raumzeitlabor/lichtsteuerung/README.md

RaumZeitLabor Lichtsteuerung
============================

https://wiki.raumzeitlabor.de/wiki/Lichtsteuerung
