raumzeitlabor/lichtsteuerung/Lichtsteuerung_bot.png

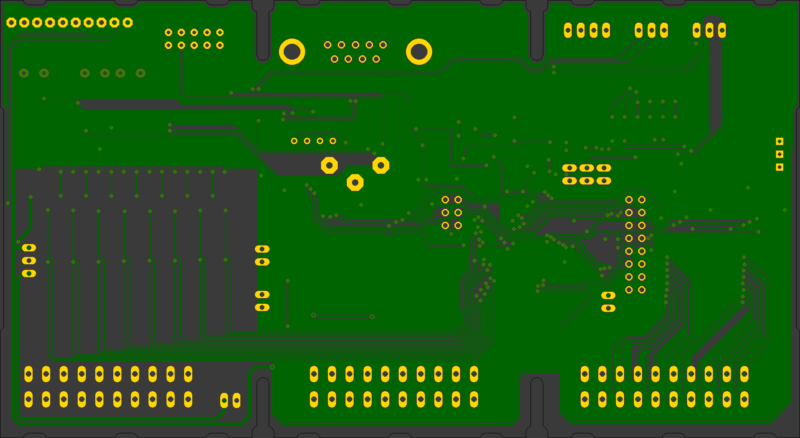
Lichtsteuerung_bot.png
