raumzeitlabor/lichtsteuerung/Lichtsteuerung_sheet1.png

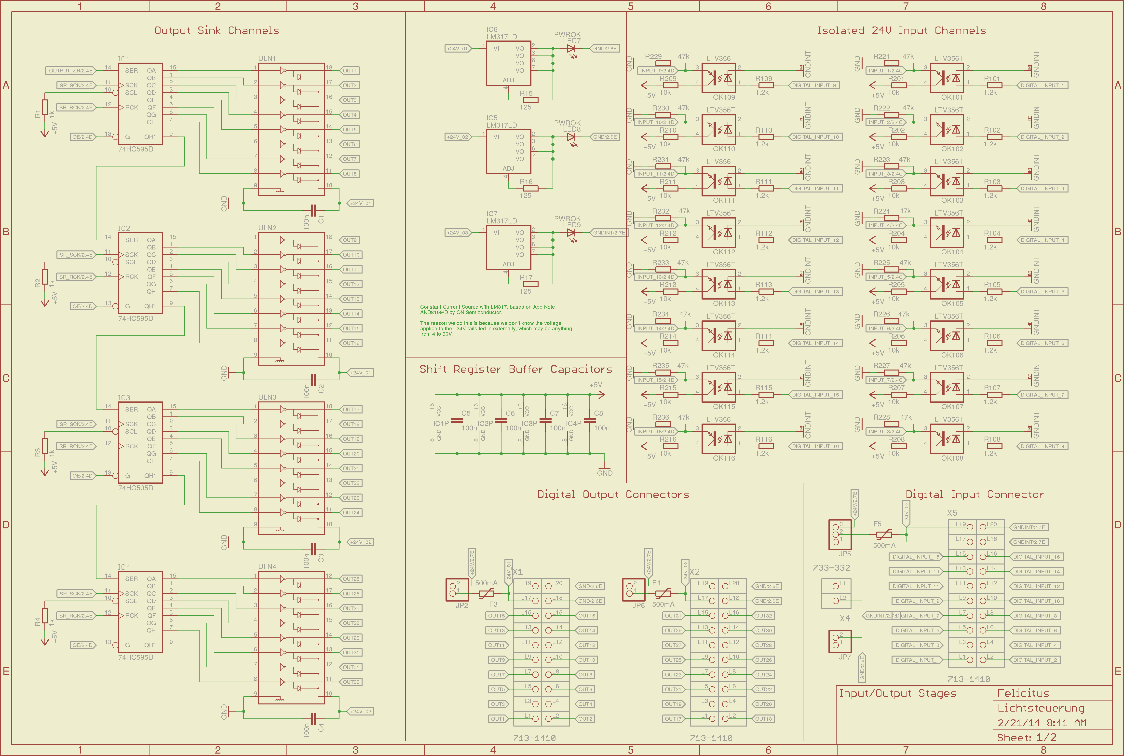
Lichtsteuerung_sheet1.png
