raumzeitlabor/lichtsteuerung/Lichtsteuerung_sheet2.png

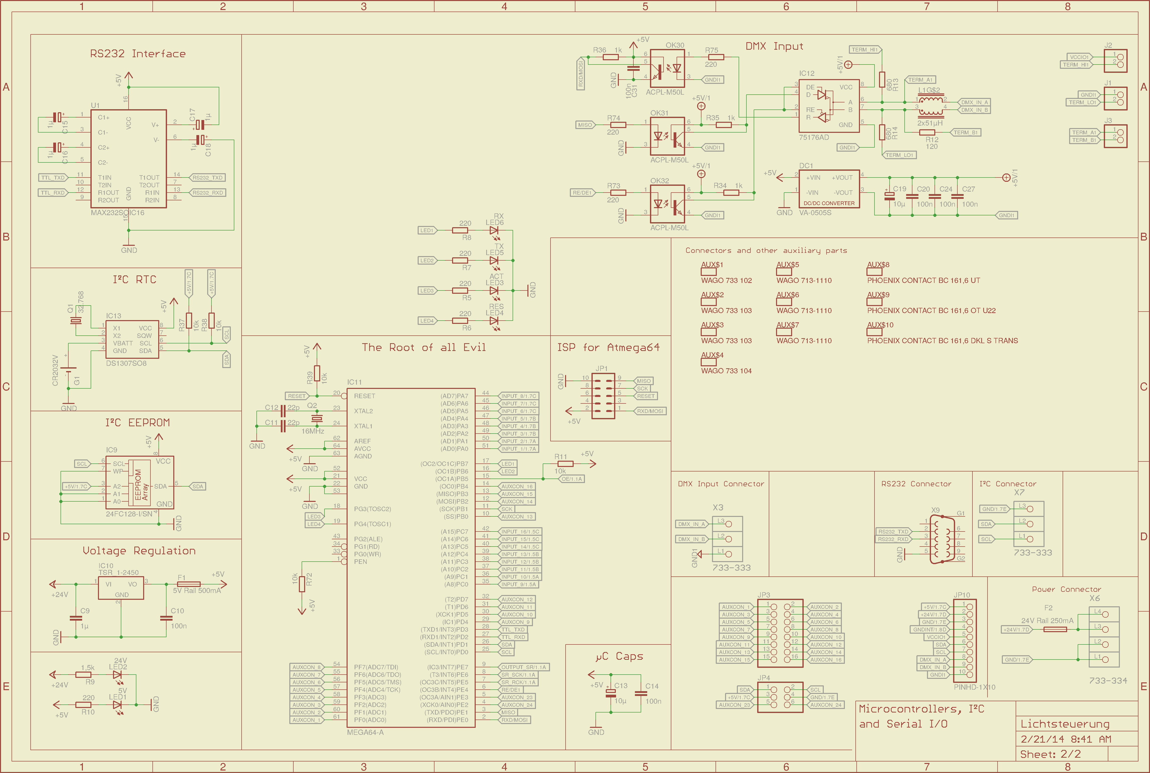
Lichtsteuerung_sheet2.png
