raumzeitlabor/lichtsteuerung/Lichtsteuerung_top.png

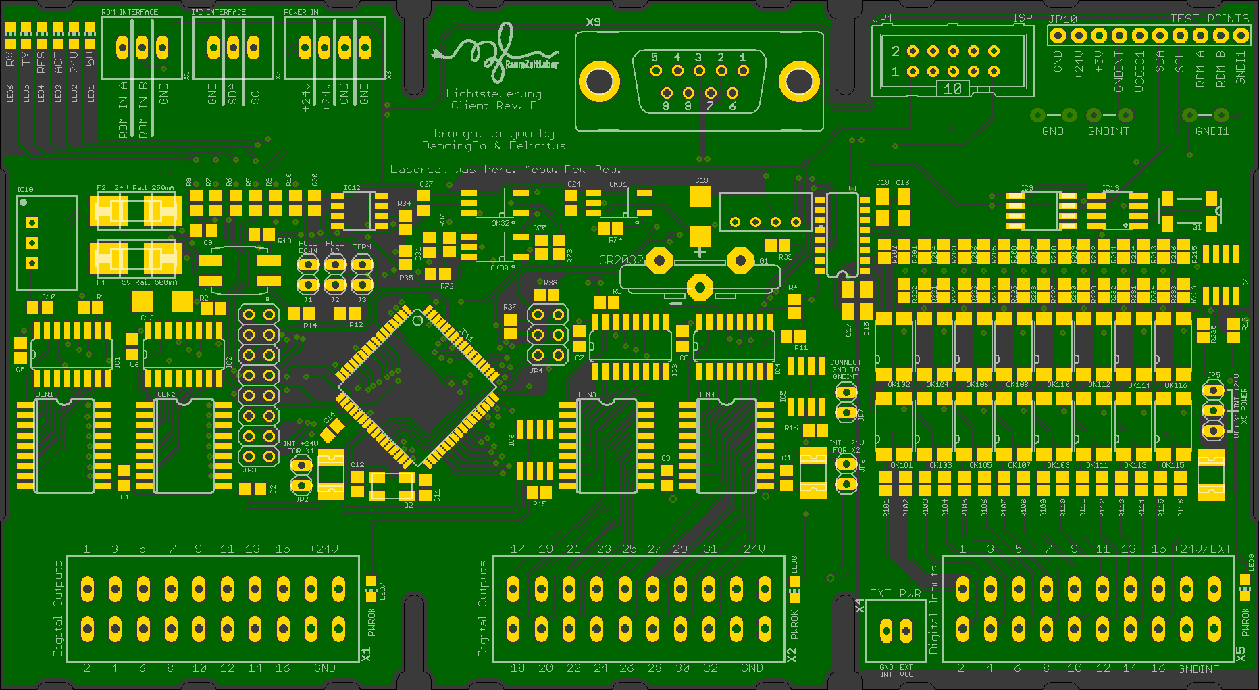
Lichtsteuerung_top.png
