raumzeitlabor/lichtsteuerung/Lichtsteuerung.brd

## EAGLE design Lichtsteuerung.brd (2016-08-28)

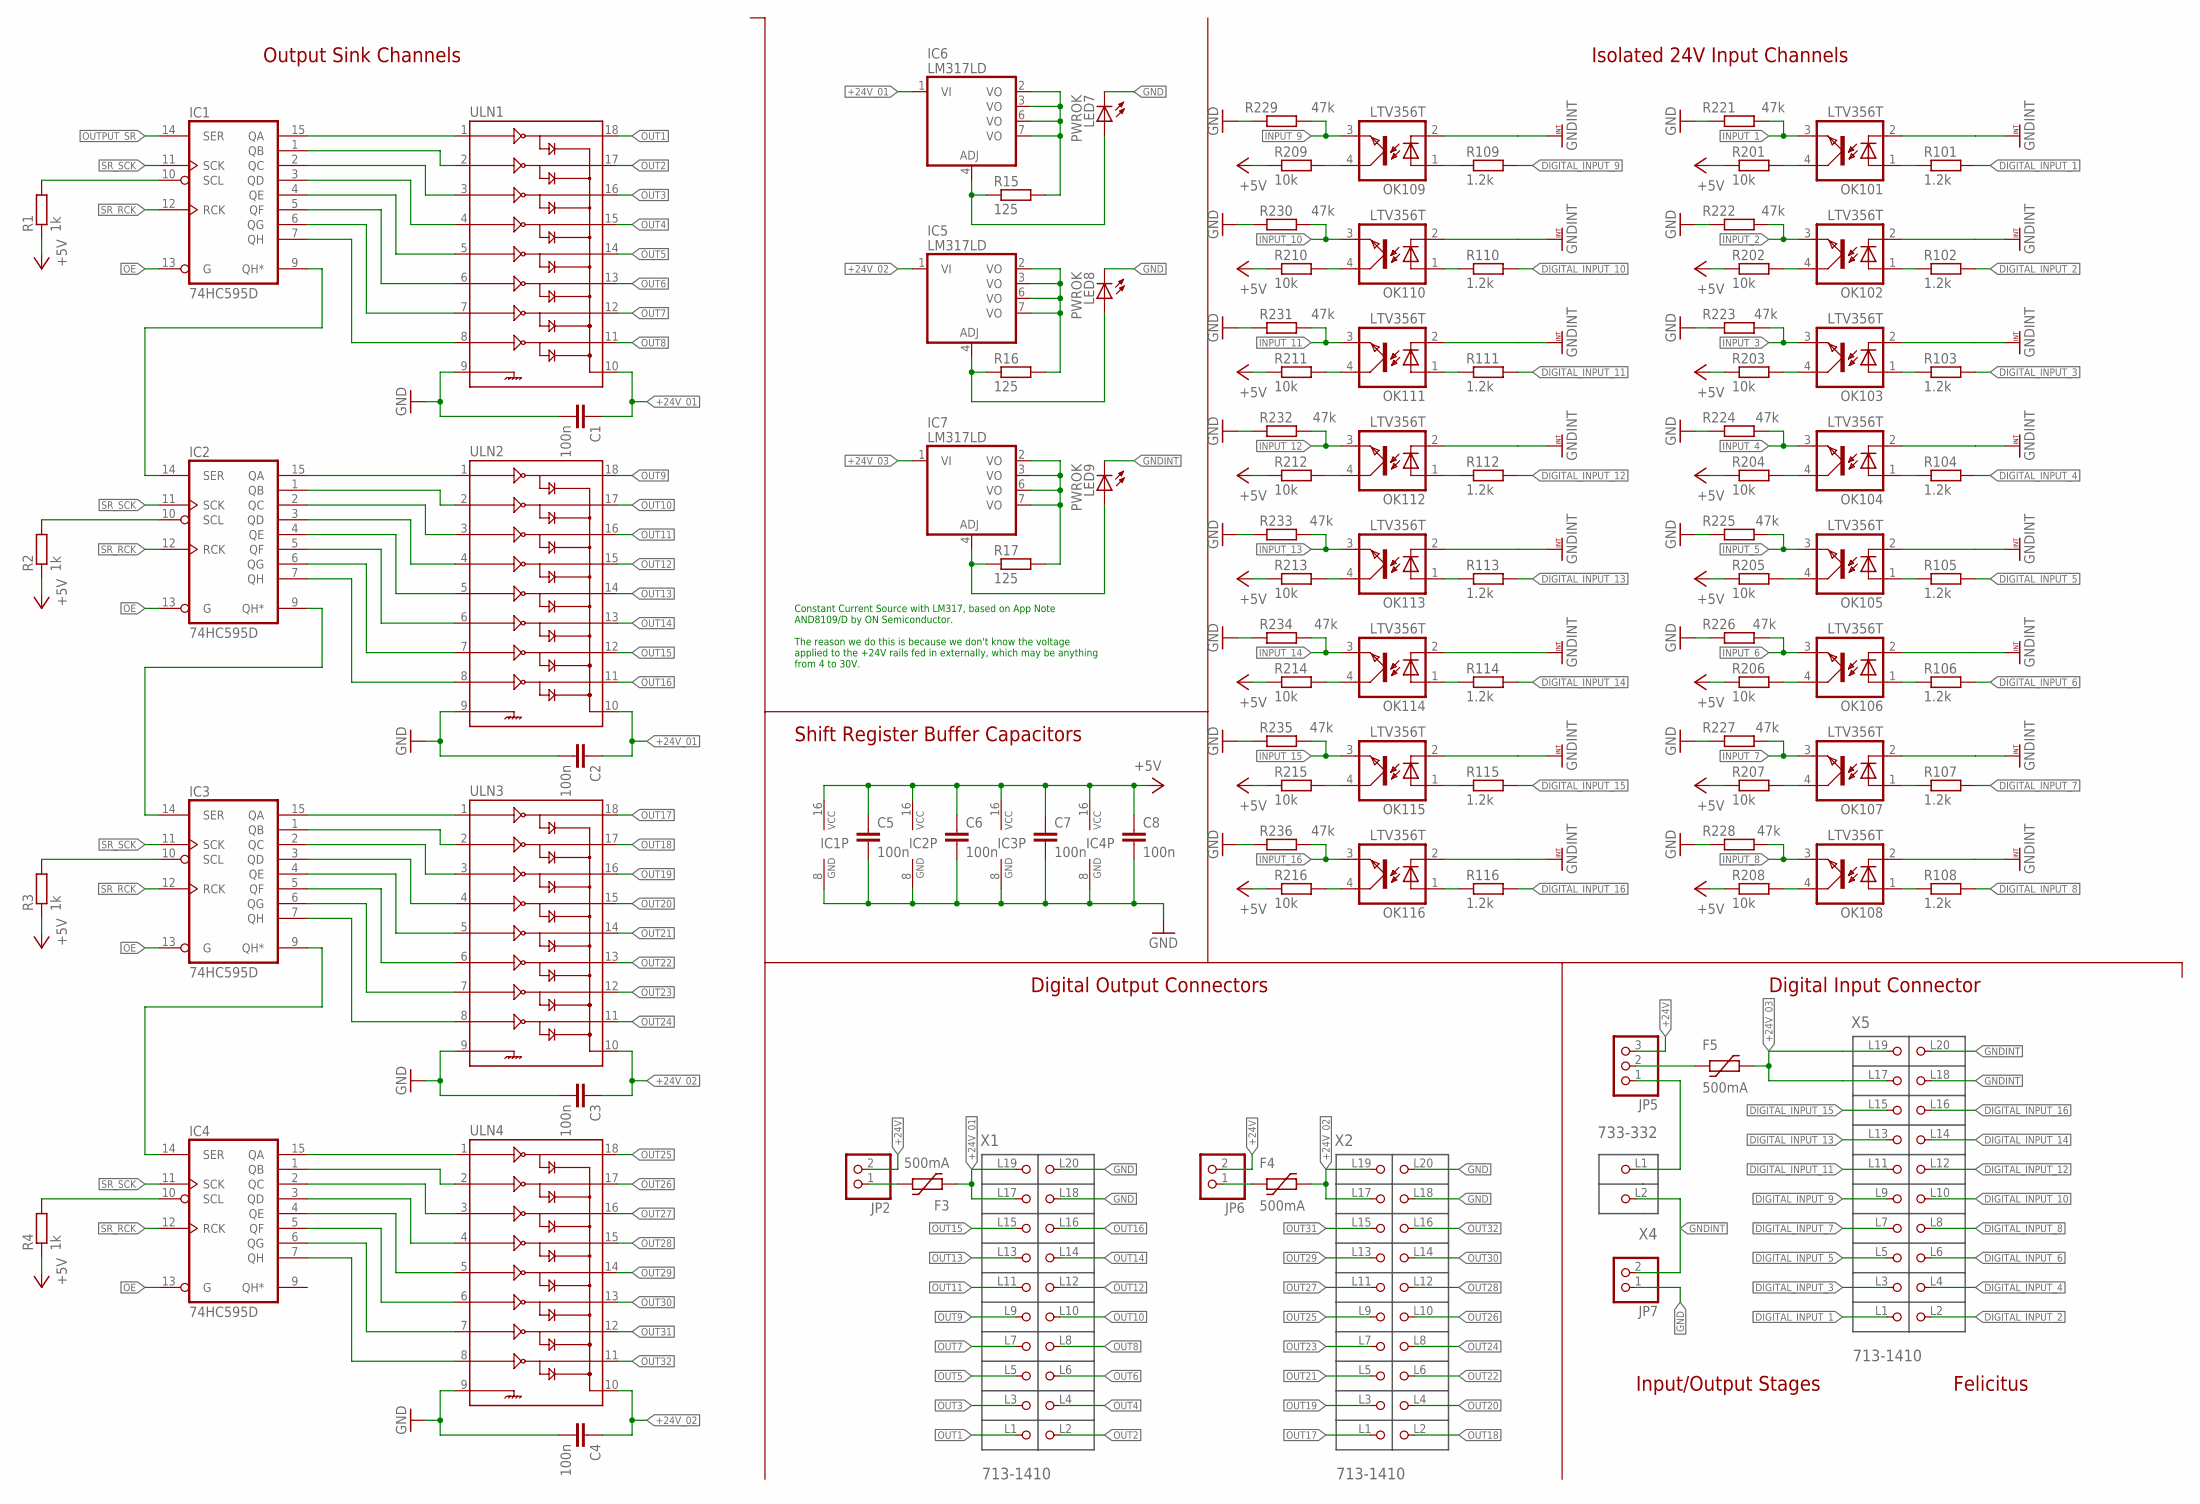
[picture p5: schematic Lichtsteuerung.sch, sheet 1]

Parts:
C1, C2, C3, C4, C5, C6, C7, C8: 100n; C0805
F3, F4, F5: 500mA; 1812L
IC1, IC2, IC3, IC4: 74HC595D; SO16
IC5, IC6, IC7: LM317LD; SO08
JP2, JP6, JP7: PINHD-1X2; 1X02
JP5: PINHD-1X3; 1X03
LED7, LED8, LED9: PWROK; CHIP-LED0805
OK101, OK102, OK103, OK104, OK105, OK106, OK107, OK108, OK109, OK110, OK111, OK112, OK113, OK114, OK115, OK116: LTV356T; SMD4
R1, R2, R3, R4: 1k; R0805
R15, R16, R17: 125; R0805
R101, R102, R103, R104, R105, R106, R107, R108, R109, R110, R111, R112, R113, R114, R115, R116: 1.2k; R0805
R201, R202, R203, R204, R205, R206, R207, R208, R209, R210, R211, R212, R213, R214, R215, R216: 10k; R0805
R221, R222, R223, R224, R225, R226, R227, R228, R229, R230, R231, R232, R233, R234, R235, R236: 47k; R0805
ULN1, ULN2, ULN3, ULN4: ULN2803SOICW; SO18L
X1, X2, X5: 713-1410; P-713-1410
X4: 733-332; P-733-332

Connections:
+5V: C5.1, C6.1, C7.1, C8.1, IC1.16 (VCC), IC2.16 (VCC), IC3.16 (VCC), IC4.16 (VCC), R1.1, R2.1, R3.1, R4.1, R201.1, R202.1, R203.1, R204.1, R205.1, R206.1, R207.1, R208.1, R209.1, R210.1, R211.1, R212.1, R213.1, R214.1, R215.1, R216.1; also elsewhere on the board
+24V: JP2.2, JP5.3, JP6.2; also elsewhere on the board
+24V_01: C1.1, C2.1, F3.P$1 (1), IC6.1 (VI), ULN1.10, ULN2.10, X1.L17, X1.L19
+24V_02: C3.1, C4.1, F4.P$2 (2), IC5.1 (VI), ULN3.10, ULN4.10, X2.L17, X2.L19
+24V_03: F5.P$2 (2), IC7.1 (VI), X5.L17, X5.L19
DIGITAL_INPUT_1: R101.2, X5.L1
DIGITAL_INPUT_2: R102.2, X5.L2
DIGITAL_INPUT_3: R103.2, X5.L3
DIGITAL_INPUT_4: R104.2, X5.L4
DIGITAL_INPUT_5: R105.2, X5.L5
DIGITAL_INPUT_6: R106.2, X5.L6
DIGITAL_INPUT_7: R107.2, X5.L7
DIGITAL_INPUT_8: R108.2, X5.L8
DIGITAL_INPUT_9: R109.2, X5.L9
DIGITAL_INPUT_10: R110.2, X5.L10
DIGITAL_INPUT_11: R111.2, X5.L11
DIGITAL_INPUT_12: R112.2, X5.L12
DIGITAL_INPUT_13: R113.2, X5.L13
DIGITAL_INPUT_14: R114.2, X5.L14
DIGITAL_INPUT_15: R115.2, X5.L15
DIGITAL_INPUT_16: R116.2, X5.L16
GND: C1.2, C2.2, C3.2, C4.2, C5.2, C6.2, C7.2, C8.2, IC1.8 (GND), IC2.8 (GND), IC3.8 (GND), IC4.8 (GND), JP7.1, LED7.C, LED8.C, R221.1, R222.1, R223.1, R224.1, R225.1, R226.1, R227.1, R228.1, R229.1, R230.1, R231.1, R232.1, R233.1, R234.1, R235.1, R236.1, ULN1.9, ULN2.9, ULN3.9, ULN4.9, X1.L18, X1.L20, X2.L18, X2.L20; also elsewhere on the board
GNDINT: JP7.2, LED9.C, OK101.2 (C), OK102.2 (C), OK103.2 (C), OK104.2 (C), OK105.2 (C), OK106.2 (C), OK107.2 (C), OK108.2 (C), OK109.2 (C), OK110.2 (C), OK111.2 (C), OK112.2 (C), OK113.2 (C), OK114.2 (C), OK115.2 (C), OK116.2 (C), X4.L2 (P2), X5.L18, X5.L20; also elsewhere on the board
INPUT_1: OK101.3 (EMIT), R221.2; also elsewhere on the board
INPUT_2: OK102.3 (EMIT), R222.2; also elsewhere on the board
INPUT_3: OK103.3 (EMIT), R223.2; also elsewhere on the board
INPUT_4: OK104.3 (EMIT), R224.2; also elsewhere on the board
INPUT_5: OK105.3 (EMIT), R225.2; also elsewhere on the board
INPUT_6: OK106.3 (EMIT), R226.2; also elsewhere on the board
INPUT_7: OK107.3 (EMIT), R227.2; also elsewhere on the board
INPUT_8: OK108.3 (EMIT), R228.2; also elsewhere on the board
INPUT_9: OK109.3 (EMIT), R229.2; also elsewhere on the board
INPUT_10: OK110.3 (EMIT), R230.2; also elsewhere on the board
INPUT_11: OK111.3 (EMIT), R231.2; also elsewhere on the board
INPUT_12: OK112.3 (EMIT), R232.2; also elsewhere on the board
INPUT_13: OK113.3 (EMIT), R233.2; also elsewhere on the board
INPUT_14: OK114.3 (EMIT), R234.2; also elsewhere on the board
INPUT_15: OK115.3 (EMIT), R235.2; also elsewhere on the board
INPUT_16: OK116.3 (EMIT), R236.2; also elsewhere on the board
unnamed: IC1.15 (QA), ULN1.1
unnamed: IC1.1 (QB), ULN1.2
unnamed: IC1.2 (QC), ULN1.3
unnamed: IC1.3 (QD), ULN1.4
unnamed: IC1.4 (QE), ULN1.5
unnamed: IC1.5 (QF), ULN1.6
unnamed: IC1.6 (QG), ULN1.7
unnamed: IC1.7 (QH), ULN1.8
unnamed: IC2.15 (QA), ULN2.1
unnamed: IC2.1 (QB), ULN2.2
unnamed: IC2.2 (QC), ULN2.3
unnamed: IC2.3 (QD), ULN2.4
unnamed: IC2.4 (QE), ULN2.5
unnamed: IC2.5 (QF), ULN2.6
unnamed: IC2.6 (QG), ULN2.7
unnamed: IC2.7 (QH), ULN2.8
unnamed: IC3.15 (QA), ULN3.1
unnamed: IC3.1 (QB), ULN3.2
unnamed: IC3.2 (QC), ULN3.3
unnamed: IC3.3 (QD), ULN3.4
unnamed: IC3.4 (QE), ULN3.5
unnamed: IC3.5 (QF), ULN3.6
unnamed: IC3.6 (QG), ULN3.7
unnamed: IC3.7 (QH), ULN3.8
unnamed: IC4.15 (QA), ULN4.1
unnamed: IC4.1 (QB), ULN4.2
unnamed: IC4.2 (QC), ULN4.3
unnamed: IC4.3 (QD), ULN4.4
unnamed: IC4.4 (QE), ULN4.5
unnamed: IC4.5 (QF), ULN4.6
unnamed: IC4.6 (QG), ULN4.7
unnamed: IC4.7 (QH), ULN4.8
unnamed: IC1.9 (QH*), IC2.14 (SER)
unnamed: IC2.9 (QH*), IC3.14 (SER)
unnamed: IC3.9 (QH*), IC4.14 (SER)
unnamed: IC1.10 (SCL), R1.2
unnamed: IC2.10 (SCL), R2.2
unnamed: IC3.10 (SCL), R3.2
unnamed: IC4.10 (SCL), R4.2
unnamed: F5.P$1 (1), JP5.2
unnamed: JP5.1, X4.L1 (P1)
unnamed: OK101.1 (A), R101.1
unnamed: OK101.4 (COL), R201.2
unnamed: OK102.1 (A), R102.1
unnamed: OK102.4 (COL), R202.2
unnamed: OK103.1 (A), R103.1
unnamed: OK103.4 (COL), R203.2
unnamed: OK104.1 (A), R104.1
unnamed: OK104.4 (COL), R204.2
unnamed: OK105.1 (A), R105.1
unnamed: OK105.4 (COL), R205.2
unnamed: OK106.1 (A), R106.1
unnamed: OK106.4 (COL), R206.2
unnamed: OK107.1 (A), R107.1
unnamed: OK107.4 (COL), R207.2
unnamed: OK108.1 (A), R108.1
unnamed: OK108.4 (COL), R208.2
unnamed: OK109.1 (A), R109.1
unnamed: OK109.4 (COL), R209.2
unnamed: OK110.1 (A), R110.1
unnamed: OK110.4 (COL), R210.2
unnamed: OK111.1 (A), R111.1
unnamed: F4.P$1 (1), JP6.1
unnamed: OK111.4 (COL), R211.2
unnamed: F3.P$2 (2), JP2.1
unnamed: OK112.1 (A), R112.1
unnamed: IC5.4 (ADJ), LED8.A, R16.1
unnamed: OK112.4 (COL), R212.2
unnamed: IC5.2 (VO), IC5.3 (VO), IC5.6 (VO), IC5.7 (VO), R16.2
unnamed: IC7.4 (ADJ), LED9.A, R17.1
unnamed: OK113.1 (A), R113.1
unnamed: IC6.4 (ADJ), LED7.A, R15.1
unnamed: IC6.2 (VO), IC6.3 (VO), IC6.6 (VO), IC6.7 (VO), R15.2
unnamed: OK113.4 (COL), R213.2
unnamed: IC7.2 (VO), IC7.3 (VO), IC7.6 (VO), IC7.7 (VO), R17.2
unnamed: OK114.1 (A), R114.1
unnamed: OK114.4 (COL), R214.2
unnamed: OK115.1 (A), R115.1
unnamed: OK115.4 (COL), R215.2
unnamed: OK116.1 (A), R116.1
unnamed: OK116.4 (COL), R216.2
OE: IC1.13 (G), IC2.13 (G), IC3.13 (G), IC4.13 (G); also elsewhere on the board
OUT1: ULN1.18, X1.L1
OUT2: ULN1.17, X1.L2
OUT3: ULN1.16, X1.L3
OUT4: ULN1.15, X1.L4
OUT5: ULN1.14, X1.L5
OUT6: ULN1.13, X1.L6
OUT7: ULN1.12, X1.L7
OUT8: ULN1.11, X1.L8
OUT9: ULN2.18, X1.L9
OUT10: ULN2.17, X1.L10
OUT11: ULN2.16, X1.L11
OUT12: ULN2.15, X1.L12
OUT13: ULN2.14, X1.L13
OUT14: ULN2.13, X1.L14
OUT15: ULN2.12, X1.L15
OUT16: ULN2.11, X1.L16
OUT17: ULN3.18, X2.L1
OUT18: ULN3.17, X2.L2
OUT19: ULN3.16, X2.L3
OUT20: ULN3.15, X2.L4
OUT21: ULN3.14, X2.L5
OUT22: ULN3.13, X2.L6
OUT23: ULN3.12, X2.L7
OUT24: ULN3.11, X2.L8
OUT25: ULN4.18, X2.L9
OUT26: ULN4.17, X2.L10
OUT27: ULN4.16, X2.L11
OUT28: ULN4.15, X2.L12
OUT29: ULN4.14, X2.L13
OUT30: ULN4.13, X2.L14
OUT31: ULN4.12, X2.L15
OUT32: ULN4.11, X2.L16
OUTPUT_SR: IC1.14 (SER); also elsewhere on the board
SR_RCK: IC1.12 (RCK), IC2.12 (RCK), IC3.12 (RCK), IC4.12 (RCK); also elsewhere on the board
SR_SCK: IC1.11 (SCK), IC2.11 (SCK), IC3.11 (SCK), IC4.11 (SCK); also elsewhere on the board

Notes on the sheet:
Felicitus
Output Sink Channels
Shift Register Buffer Capacitors
Input/Output Stages
Isolated 24V Input Channels
Digital Input Connector
Digital Output Connectors
Constant Current Source with LM317, based on App Note AND8109/D by ON Semiconductor. The reason we do this is because we don't know the voltage applied to the +24V rails fed in externally, which may be anything from 4 to 30V.

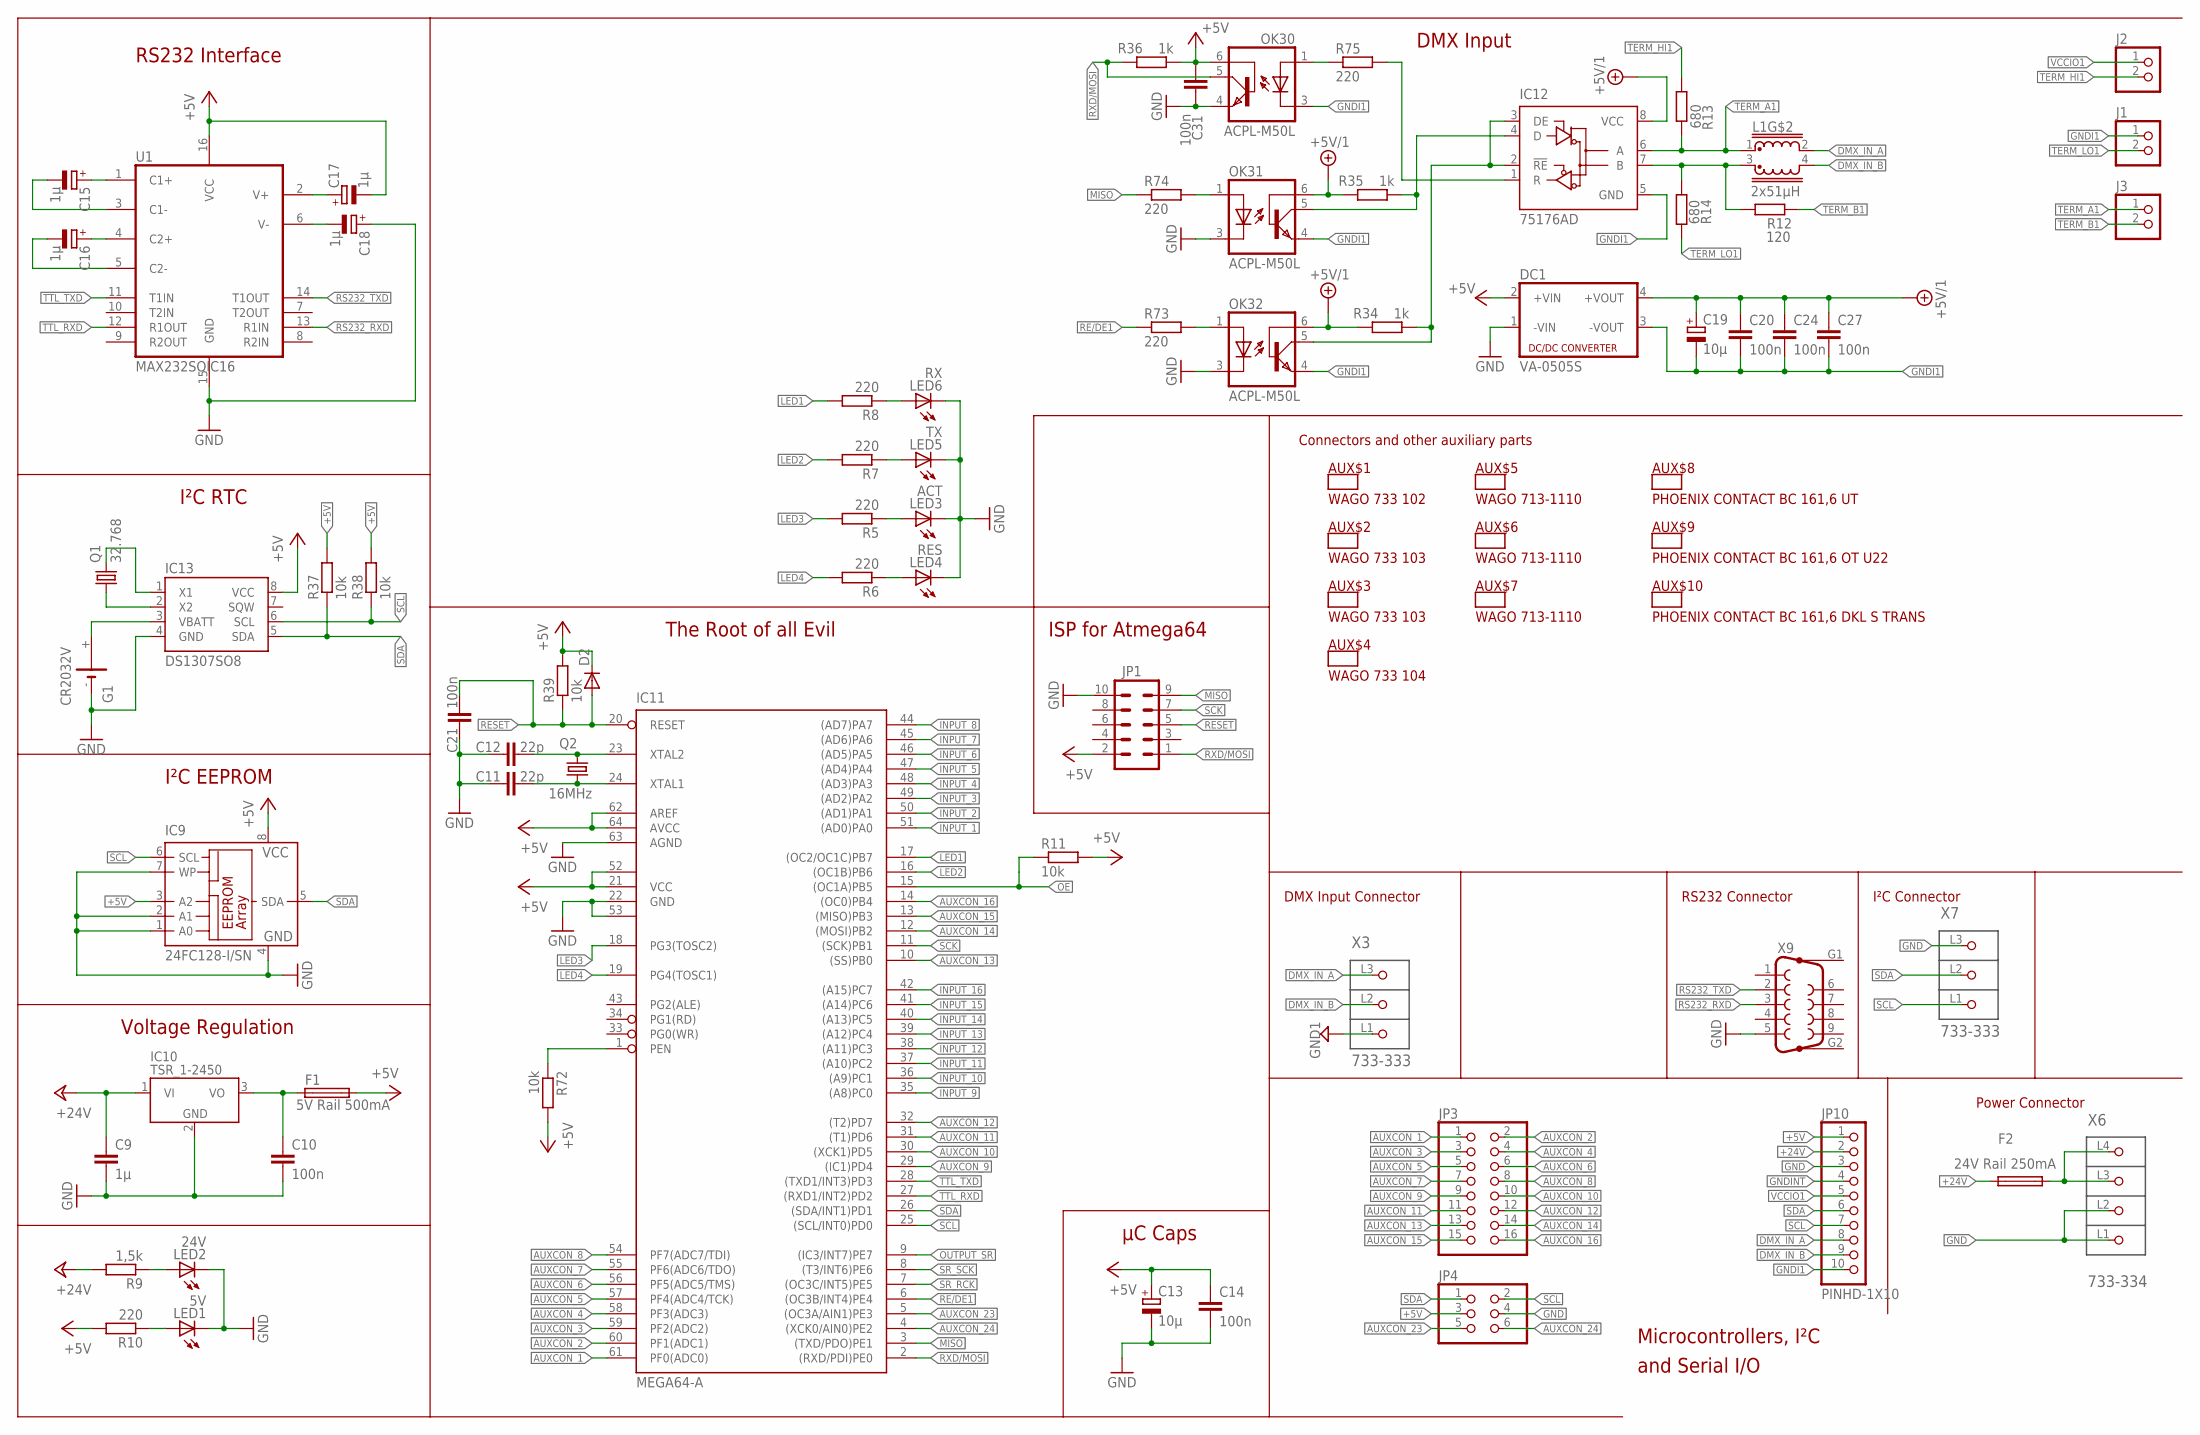
[picture p6: schematic Lichtsteuerung.sch, sheet 2]

Parts:
C9: 1µ; C0805
C10, C14, C20, C21, C24, C27, C31: 100n; C0805
C11, C12: 22p; C0805
C13, C19: 10µ; C/6032-28R; PARTKEEPR_SKU 2607
C15, C16, C17, C18: 1µ; A/3216-18R; PARTKEEPR_SKU 2609
D2: DIODE-SOD323-R; SOD323-R
DC1: VA-0505S; 4SIL
F1: 5V Rail 500mA; OMNIBLOK
F2: 24V Rail 250mA; OMNIBLOK
G1: CR2032V; CR2032V2
IC9: 24FC128-I/SN; SO-08M
IC10: TSR_1-2450; TSR-1
IC11: MEGA64-A; TQFP64
IC12: 75176AD; D_R-PDSO-G8
IC13: DS1307SO8; SO08
J1, J2, J3: PINHD-1X2; 1X02
JP1: ML10
JP3: PINHD-2X8; 2X08
JP4: PINHD-2X3; 2X03
JP10: PINHD-1X10; 1X10-BIG
L1: 2x51µH; EPCOS_B82790_SERIES
LED1: 5V; CHIP-LED0805
LED2: 24V; CHIP-LED0805
LED3: ACT; CHIP-LED0805
LED4: RES; CHIP-LED0805
LED5: TX; CHIP-LED0805
LED6: RX; CHIP-LED0805
OK30, OK31, OK32: ACPL-M50L; JEDEC_MS-012-AA_SOIC5
Q1: 32.768; MC-306
Q2: 16MHz; MJ
R5, R6, R7, R8, R10, R73, R74, R75: 220; R0805
R9: 1,5k; R0805
R11, R37, R38, R39, R72: 10k; R0805
R12: 120; R0805
R13, R14: 680; R0805
R34, R35, R36: 1k; R0805
U1: MAX232SOIC16; SO016
X3, X7: 733-333; P-733-333
X6: 733-334; P-733-334
X9: F09VP

Connections:
+5V: C13.+, C14.1, C17.-, C31.1, D2.C, DC1.2 (+VIN), F1.P$2 (2), IC9.3 (A2), IC9.8 (VCC), IC11.21 (VCC), IC11.52 (VCC1), IC11.62 (AREF), IC11.64 (AVCC), IC13.8 (VCC), JP1.2, JP4.3, JP10.1, OK30.6 (BAS), R10.2, R11.2, R36.1, R37.2, R38.2, R39.2, R72.2, U1.16 (VCC); also elsewhere on the board
+24V: C9.1, F2.P$1 (1), IC10.1 (VI), JP10.2, R9.2; also elsewhere on the board
+24VIN: F2.P$2 (2), X6.L3 (P3), X6.L4 (P4)
AUXCON_1: IC11.61 (PF0(ADC0)), JP3.1
AUXCON_2: IC11.60 (PF1(ADC1)), JP3.2
AUXCON_3: IC11.59 (PF2(ADC2)), JP3.3
AUXCON_4: IC11.58 (PF3(ADC3)), JP3.4
AUXCON_5: IC11.57 (PF4(ADC4/TCK)), JP3.5
AUXCON_6: IC11.56 (PF5(ADC5/TMS)), JP3.6
AUXCON_7: IC11.55 (PF6(ADC6/TDO)), JP3.7
AUXCON_8: IC11.54 (PF7(ADC7/TDI)), JP3.8
AUXCON_9: IC11.29 ((IC1)PD4), JP3.9
AUXCON_10: IC11.30 ((XCK1)PD5), JP3.10
AUXCON_11: IC11.31 ((T1)PD6), JP3.11
AUXCON_12: IC11.32 ((T2)PD7), JP3.12
AUXCON_13: IC11.10 ((SS)PB0), JP3.13
AUXCON_14: IC11.12 ((MOSI)PB2), JP3.14
AUXCON_15: IC11.13 ((MISO)PB3), JP3.15
AUXCON_16: IC11.14 ((OC0)PB4), JP3.16
AUXCON_23: IC11.5 ((OC3A/AIN1)PE3), JP4.5
AUXCON_24: IC11.4 ((XCK0/AIN0)PE2), JP4.6
DMX_IN_A: JP10.8, L1.2 (4), X3.L3 (P3)
DMX_IN_B: JP10.9, L1.4, X3.L2 (P2)
GND: C9.2, C10.2, C11.2, C12.2, C13.-, C14.2, C18.+, C21.2, C31.2, DC1.1 (-VIN), G1.-, IC9.1 (A0), IC9.2 (A1), IC9.4 (GND), IC9.7 (WP), IC10.2 (GND), IC11.22 (GND), IC11.53 (GND1), IC11.63 (AGND), IC13.4 (GND), JP1.10, JP4.4, JP10.3, LED1.C, LED2.C, LED3.C, LED4.C, LED5.C, LED6.C, OK30.4 (EMI), OK31.3 (C), OK32.3 (C), U1.15 (GND), X6.L1 (P1), X6.L2 (P2), X7.L3 (P3), X9.5; also elsewhere on the board
GNDI1: C19.-, C20.2, C24.2, C27.2, DC1.3 (-VOUT), IC12.5 (GND), J1.1, JP10.10, OK30.3 (C), OK31.4 (EMI), OK32.4 (EMI), X3.L1 (P1)
GNDINT: JP10.4; also elsewhere on the board
INPUT_1: IC11.51 ((AD0)PA0); also elsewhere on the board
INPUT_2: IC11.50 ((AD1)PA1); also elsewhere on the board
INPUT_3: IC11.49 ((AD2)PA2); also elsewhere on the board
INPUT_4: IC11.48 ((AD3)PA3); also elsewhere on the board
INPUT_5: IC11.47 ((AD4)PA4); also elsewhere on the board
INPUT_6: IC11.46 ((AD5)PA5); also elsewhere on the board
INPUT_7: IC11.45 ((AD6)PA6); also elsewhere on the board
INPUT_8: IC11.44 ((AD7)PA7); also elsewhere on the board
INPUT_9: IC11.35 ((A8)PC0); also elsewhere on the board
INPUT_10: IC11.36 ((A9)PC1); also elsewhere on the board
INPUT_11: IC11.37 ((A10)PC2); also elsewhere on the board
INPUT_12: IC11.38 ((A11)PC3); also elsewhere on the board
INPUT_13: IC11.39 ((A12)PC4); also elsewhere on the board
INPUT_14: IC11.40 ((A13)PC5); also elsewhere on the board
INPUT_15: IC11.41 ((A14)PC6); also elsewhere on the board
INPUT_16: IC11.42 ((A15)PC7); also elsewhere on the board
LED1: IC11.17 ((OC2/OC1C)PB7), R8.2
LED2: IC11.16 ((OC1B)PB6), R7.2
LED3: IC11.18 (PG3(TOSC2)), R5.2
LED4: IC11.19 (PG4(TOSC1)), R6.2
MISO: IC11.3 ((TXD/PDO)PE1), JP1.9, R74.1
unnamed: G1.+, IC13.3 (VBATT)
unnamed: C11.1, IC11.24 (XTAL1), Q2.P3 (2)
unnamed: IC13.2 (X2), Q1.1
unnamed: IC13.1 (X1), Q1.4 (2)
unnamed: C12.1, IC11.23 (XTAL2), Q2.P1 (1)
unnamed: LED6.A, R8.1
unnamed: LED5.A, R7.1
unnamed: LED3.A, R5.1
unnamed: C15.+, U1.1 (C1+)
unnamed: C15.-, U1.3 (C1-)
unnamed: LED4.A, R6.1
unnamed: LED1.A, R10.1
unnamed: LED2.A, R9.1
unnamed: IC11.1 (PEN), R72.1
unnamed: C16.+, U1.4 (C2+)
unnamed: C16.-, U1.5 (C2-)
unnamed: C10.1, F1.P$1 (1), IC10.3 (VO)
unnamed: IC12.7 (B), L1.3 (1), R12.2, R14.2
unnamed: OK30.1 (A), R75.1
unnamed: OK31.1 (A), R74.2
unnamed: OK32.1 (A), R73.2
unnamed: C18.-, U1.6 (V-)
unnamed: C17.+, U1.2 (V+)
OE: IC11.15 ((OC1A)PB5), R11.1; also elsewhere on the board
OUTPUT_SR: IC11.9 ((IC3/INT7)PE7); also elsewhere on the board
RE/DE1: IC11.6 ((OC3B/INT4)PE4), R73.1
REC$1: IC12.1 (R), R75.2
RESET: C21.1, D2.A, IC11.20 (RESET), JP1.5, R39.1
RE_OUT: IC12.2 (!RE), IC12.3 (DE), OK32.5 (COL), R34.1
RS232_RXD: U1.13 (R1IN), X9.3
RS232_TXD: U1.14 (T1OUT), X9.2
RXD/MOSI: IC11.2 ((RXD/PDI)PE0), JP1.1, OK30.5 (COL), R36.2
SCK: IC11.11 ((SCK)PB1), JP1.7
SCL: IC9.6 (SCL), IC11.25 ((SCL/INT0)PD0), IC13.6 (SCL), JP4.2, JP10.7, R38.1, X7.L1 (P1)
SDA: IC9.5 (SDA), IC11.26 ((SDA/INT1)PD1), IC13.5 (SDA), JP4.1, JP10.6, R37.1, X7.L2 (P2)
SR_RCK: IC11.7 ((OC3C/INT5)PE5); also elsewhere on the board
SR_SCK: IC11.8 ((T3/INT6)PE6); also elsewhere on the board
TERM_A1: IC12.6 (A), J3.1, L1.1, R13.1
TERM_B1: J3.2, R12.1
TERM_HI1: J2.2, R13.2
TERM_LO1: J1.2, R14.1
TTL_RXD: IC11.27 ((RXD1/INT2)PD2), U1.12 (R1OUT)
TTL_TXD: IC11.28 ((TXD1/INT3)PD3), U1.11 (T1IN)
TXD_OUT: IC12.4 (D), OK31.5 (COL), R35.1
VCCIO1: C19.+, C20.1, C24.1, C27.1, DC1.4 (+VOUT), IC12.8 (VCC), J2.1, JP10.5, OK31.6 (BAS), OK32.6 (BAS), R34.2, R35.2

Notes on the sheet:
I²C EEPROM
I²C RTC
Voltage Regulation
DMX Input
ISP for Atmega64
µC Caps
RS232 Interface
The Root of all Evil
Microcontrollers, I²C
and Serial I/O
DMX Input Connector
RS232 Connector
I²C Connector
Power Connector
Connectors and other auxiliary parts

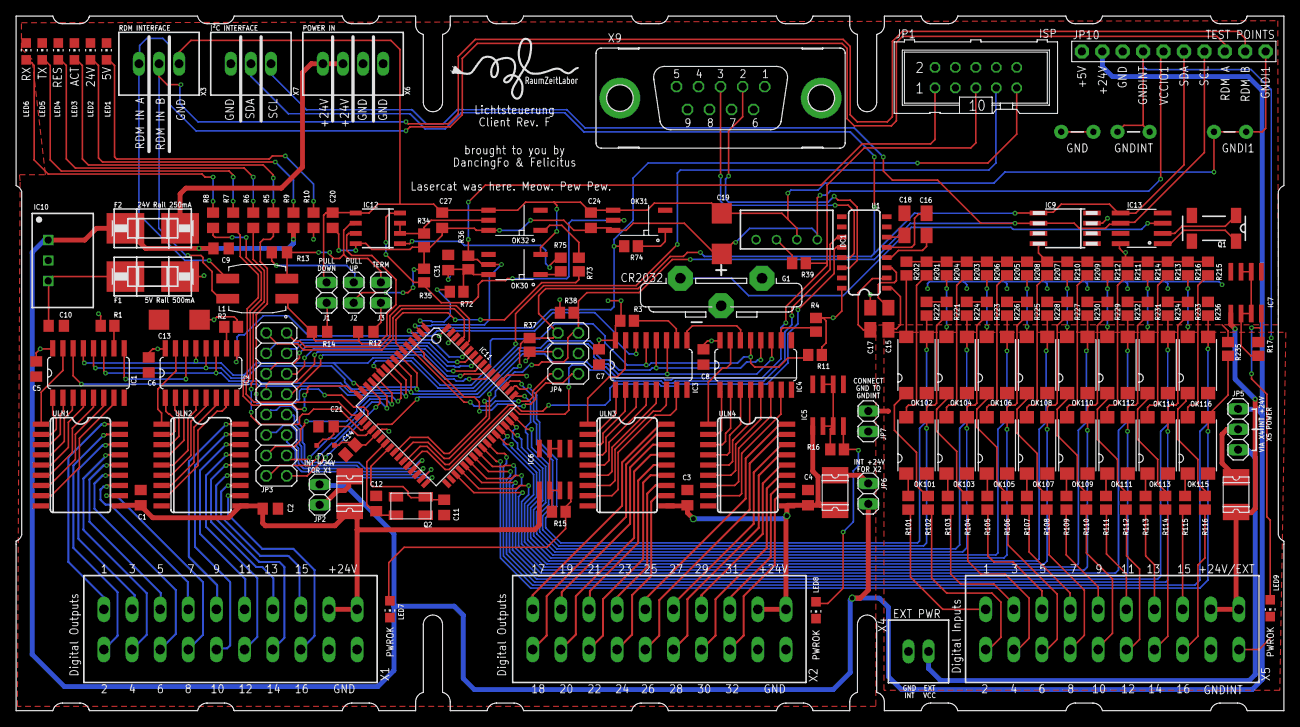
[picture p7: board Lichtsteuerung.brd from above]

Board: 2 copper layers, 157.7 x 86.4 mm, 175 parts (0 on the bottom side), 224 nets.

Other parts of the board:
U$1: RAUMZEITLABOR_FILLED_16MM
