raumzeitlabor/lichtsteuerung/firmware/Lichtsteuerung/bitlashfunctions.ino

#include <avr/pgmspace.h>
#include <bitlash.h>
#include <src/bitlash.h>

#define MODE_TOGGLE 1
#define MODE_MOMENTARY 2
#define MODE_INVALID 99

char buffer[120];

const char usage_setOutputState[] PROGMEM = "Usage: setOutputState(output,state)\n\routput: Output Number (1-32)\n\rstate: State (0 = off, 1 = on)\n\r";
const char usage_setDeviceName[] PROGMEM = "Usage: setDeviceName(deviceName)\n\rdeviceName: ASCII String, 32 chars max\n\r";
const char usage_setOutputName[] PROGMEM = "Usage: setOutputName(port, portName)\n\rport: Output Number (1-32)\n\rportName: ASCII String, 32 chars max\n\r";
const char usage_getOutputName[] PROGMEM = "Usage: getOutputName(port)\n\rport: Output Number (1-32)\n\r";
const char usage_getOutputState[] PROGMEM = "Usage: getOutputState(port)\n\rport: Output Number (1-32)\n\r";
const char usage_toggleOutputState[] PROGMEM = "Usage: toggleOutputState(port)\n\rport: Output Number (1-32)\n\r";
const char usage_setInputName[] PROGMEM = "Usage: setInputName(port, portName)\n\rport: Input Number (1-16)\n\rportName: ASCII String, 32 chars max\n\r";
const char usage_getInputName[] PROGMEM = "Usage: getInputName(port)\n\rport: Input Number (1-16)\n\r";
const char usage_setInputMode[] PROGMEM = "Usage: setInputMode(port,mode)\n\rport: Input Number (1-16)\n\rmode: MODE_TOGGLE or MODE_MOMENTARY\n\rExample: setInputMode(1, \"MODE_MOMENTARY\");\n\r";
const char usage_getInputMode[] PROGMEM = "Usage: getInputMode(port)\n\rport: Input Number (1-16)\n\rPrints either MODE_TOGGLE or MODE_MOMENTARY\n\r";
const char usage_setPrivateFlag[] PROGMEM = "Usage: setPrivateFlag(port, private)\n\rport: Output Number (1-32)\n\rprivate: 0=public, 1=private\n\r";
const char usage_peepE[] PROGMEM = "Usage: peep_e(start_address)\n\rDumps 4096 bytes from the external I2C EEPROM.\n\rstart_address: EEPROM Start Address in decimal or hex (e.g. 0xFFF)\n\r";

PGM_P const usage[] PROGMEM = {
	usage_setOutputState,
	usage_setDeviceName,
	usage_setOutputName,
	usage_getOutputName,
	usage_getOutputState,
	usage_toggleOutputState,
	usage_setInputName,
	usage_getInputName,
	usage_setInputMode,
	usage_getInputMode,
	usage_setPrivateFlag,
	usage_peepE
};

const char messages_setDeviceName[] PROGMEM = "New device name: ";
const char messages_invalidOutputPortNumber[] PROGMEM = "Invalid Output Port Number. Valid values are: 1-32.";
const char messages_invalidInputPortNumber[] PROGMEM = "Invalid Input Port Number. Valid values are: 1-16.";
const char messages_invalidInputMode[] PROGMEM = "Invalid port mode. Valid values are: MODE_TOGGLE or MODE_MOMENTARY.";

PGM_P const messages[] PROGMEM = {
	messages_setDeviceName,
	messages_invalidOutputPortNumber,
	messages_invalidInputPortNumber,
	messages_invalidInputMode
};

/**
 * bitlash function to set or clear an output.
 *
 * Usage: setOutputState [output] [state]
 *
 * [output]: 1-32
 * [state]: 0 for off, 1 for on
 */
numvar bl_setOutputState(void) {
	if (getarg(0) != 2) {
		strcpy_P(buffer, (PGM_P) pgm_read_word(&(usage[0])));
		Serial1.println(buffer);
		return 0;
	}

	int i = getarg(1);
	if (i < 1 || i > NUM_OUTPUTS) {
		// Output out of range error message
		strcpy_P(buffer, (PGM_P) pgm_read_word(&(messages[1])));
		Serial1.print(buffer);
		return 0;
	}

	setOutputState(i, getarg(2));
}

/**
 * bitlash function to return (not print) the output state.
 *
 * Usage: getOutputState [output]
 *
 * [output]: 1-32
 */
numvar bl_getOutputState(void) {
	if (getarg(0) != 1) {
		strcpy_P(buffer, (PGM_P) pgm_read_word(&(usage[4])));
		Serial1.println(buffer);
		return 0;
	}

	int i = getarg(1);
	if (i < 1 || i > NUM_OUTPUTS) {
		// Output out of range error message
		strcpy_P(buffer, (PGM_P) pgm_read_word(&(messages[1])));
		Serial1.print(buffer);
		return 0;
	}

	return getOutputState(i);
}

/**
 * bitlash function to toggle the output state.
 *
 * Usage: toggleOutputState [output]
 *
 * [output]: 1-32
 */
numvar bl_toggleOutputState(void) {
	if (getarg(0) != 1) {
		strcpy_P(buffer, (PGM_P) pgm_read_word(&(usage[5])));
		Serial1.println(buffer);
		return 0;
	}

	int i = getarg(1);
	if (i < 1 || i > NUM_OUTPUTS) {
		// Output out of range error message
		strcpy_P(buffer, (PGM_P) pgm_read_word(&(messages[1])));
		Serial1.print(buffer);
		return 0;
	}

	setOutputState(i, !getOutputState(i));
}
/**
 * Prints the device name to the serial output
 *
 * Usage: getDeviceName
 */
numvar bl_getDeviceName(void) {
	Serial1.println(DMXSerial2.deviceLabel);
}

/**
 * Sets the device name. ASCII only, 32 bytes max. Additional length will be cropped.
 *
 * Usage: setDeviceName [name]
 */
numvar bl_setDeviceName(void) {
	if (getarg(0) != 1) {
		strcpy_P(buffer, (PGM_P) pgm_read_word(&(usage[1])));
		Serial1.println((char *) buffer);
		return 0;
	}

	// Copy the name to the device label and save the EEPROM.
	strncpy(DMXSerial2.deviceLabel, (char *) getarg(1), MAX_LABEL_LENGTH);
	DMXSerial2._saveEEPRom();

	// Output confirmation message
	strcpy_P(buffer, (PGM_P) pgm_read_word(&(messages[0])));
	Serial1.print(buffer);
	Serial1.println(DMXSerial2.deviceLabel);
}

/**
 * Prints the DMX start address.
 *
 * Usage: getDMXStartAddress
 */
numvar bl_getDMXStartAddress(void) {
	Serial1.println(DMXSerial2.getStartAddress());
}

/**
 * Prints the RDM UID on the serial output
 *
 * Usage: getRDMUID
 */
numvar bl_getRDMUID(void) {
	byte uid[6];
	DMXSerial2.getDeviceID(uid);
	PrintHex8(uid, 2);
	Serial1.print(":");
	PrintHex8(uid + 2, 4);
	Serial1.println();
}

/**
 * Sets the output port name. ASCII only, 32 bytes max. Additional length will be cropped.
 *
 * Usage: setOutputName [port] [name]
 */
numvar bl_setOutputName(void) {
	uint8_t j;
	
	if (getarg(0) != 2) {
		strcpy_P(buffer, (PGM_P) pgm_read_word(&(usage[2])));
		Serial1.println((char *) buffer);
		return 0;
	}

	int i = getarg(1);
	if (i < 1 || i > NUM_OUTPUTS) {
		// Output out of range error message
		strcpy_P(buffer, (PGM_P) pgm_read_word(&(messages[1])));
		Serial1.print(buffer);
		return 0;
	}
	
	for (j=0;j<MAX_LABEL_LENGTH;j++) {
		i2c_eeprom_write_byte(I2C_EEPROM_ADDRESS, EEPROM_OUTPUT_NAME_OFFSET + ((i-1)*MAX_LABEL_LENGTH)+j, ((byte*)getarg(2))[j]);
		delay(10);
	}
}

/**
 * Gets the output port name.
 *
 * Usage: getOutputName [port]
 */
numvar bl_getOutputName(void) {
	int j;
	
	if (getarg(0) != 1) {
		strcpy_P(buffer, (PGM_P) pgm_read_word(&(usage[3])));
		Serial1.println((char *) buffer);
		return 0;
	}

	int i = getarg(1);
	if (i < 1 || i > NUM_OUTPUTS) {
		// Output out of range error message
		strcpy_P(buffer, (PGM_P) pgm_read_word(&(messages[1])));
		Serial1.print(buffer);
		return 0;
	}
	
	for (j=0;j<MAX_LABEL_LENGTH;j++) {
		buffer[j] = i2c_eeprom_read_byte(I2C_EEPROM_ADDRESS, EEPROM_OUTPUT_NAME_OFFSET + ((i-1)*MAX_LABEL_LENGTH)+j);
	}
	
	Serial1.println(buffer);
}

/**
 * Sets the output private flag. If an output is private, it shouldn't be listed using the spark frontend.
 *
 * Usage: setPrivateFlag [port] [private]
 */
numvar bl_setPrivateFlag(void) {
	uint8_t j;
	
	if (getarg(0) != 2) {
		strcpy_P(buffer, (PGM_P) pgm_read_word(&(usage[10])));
		Serial1.println((char *) buffer);
		return 0;
	}

	int i = getarg(1);
	if (i < 1 || i > NUM_OUTPUTS) {
		// Output out of range error message
		strcpy_P(buffer, (PGM_P) pgm_read_word(&(messages[1])));
		Serial1.print(buffer);
		return 0;
	}
	
	i2c_eeprom_write_byte(I2C_EEPROM_ADDRESS, EEPROM_OUTPUT_PRIVATE_FLAG_OFFSET + (i-1), getarg(2));
	delay(10);
}

/**
 * Sets the input port name. ASCII only, 32 bytes max. Additional length will be cropped.
 *
 * Usage: setInputName [port] [name]
 */
numvar bl_setInputName(void) {
	if (getarg(0) != 2) {
		strcpy_P(buffer, (PGM_P) pgm_read_word(&(usage[6])));
		Serial1.println((char *) buffer);
		return 0;
	}

	int i = getarg(1);
	if (i < 1 || i > NUM_INPUTS) {
		// Output out of range error message
		strcpy_P(buffer, (PGM_P) pgm_read_word(&(messages[1])));
		Serial1.print(buffer);
		return 0;
	}
	
	for (int j=0;j<MAX_LABEL_LENGTH;j++) {
		i2c_eeprom_write_byte(I2C_EEPROM_ADDRESS, EEPROM_INPUT_NAME_OFFSET + ((i-1)*MAX_LABEL_LENGTH)+j, ((byte*)getarg(2))[j]);
		delay(10);
	}
	
}

/**
 * Gets the input port name.
 *
 * Usage: getInputName [port]
 */
numvar bl_getInputName(void) {
	if (getarg(0) != 1) {
		strcpy_P(buffer, (PGM_P) pgm_read_word(&(usage[7])));
		Serial1.println((char *) buffer);
		return 0;
	}

	int i = getarg(1);
	if (i < 1 || i > NUM_INPUTS) {
		// Output out of range error message
		strcpy_P(buffer, (PGM_P) pgm_read_word(&(messages[2])));
		Serial1.print(buffer);
		return 0;
	}
	
	for (int j=0;j<MAX_LABEL_LENGTH;j++) {
		buffer[j] = i2c_eeprom_read_byte(I2C_EEPROM_ADDRESS, EEPROM_INPUT_NAME_OFFSET + ((i-1)*MAX_LABEL_LENGTH)+j);
	}
		
	Serial1.println(buffer);
}


numvar bl_setInputMode(void) {
	uint8_t mode = MODE_INVALID;
	
	if (getarg(0) != 2) {
		strcpy_P(buffer, (PGM_P) pgm_read_word(&(usage[8])));
		Serial1.println((char *) buffer);
		return 0;
	}
	
	int i = getarg(1);
	if (i < 1 || i > NUM_INPUTS) {
		// Output out of range error message
		strcpy_P(buffer, (PGM_P) pgm_read_word(&(messages[2])));
		Serial1.print(buffer);
		return 0;
	}
	
	if (strcmp((char*)getarg(2), "MODE_TOGGLE") == 0) {
		mode = MODE_TOGGLE;
		// Mode will be toggle
	}
	
	if (strcmp((char*)getarg(2), "MODE_MOMENTARY") == 0) {
		mode = MODE_MOMENTARY;
	}
	
	if (mode == MODE_INVALID) {
		strcpy_P(buffer, (PGM_P) pgm_read_word(&(messages[3])));
		Serial1.print(buffer);
		return 0;
	}
	
	i2c_eeprom_write_byte(I2C_EEPROM_ADDRESS, EEPROM_INPUT_MODE_OFFSET + (i-1), mode);
}

numvar bl_getInputMode(void) {
	int mode;
	
	if (getarg(0) != 1) {
		strcpy_P(buffer, (PGM_P) pgm_read_word(&(usage[9])));
		Serial1.println((char *) buffer);
		return 0;
	}
	
	int i = getarg(1);
	if (i < 1 || i > NUM_INPUTS) {
		// Output out of range error message
		strcpy_P(buffer, (PGM_P) pgm_read_word(&(messages[2])));
		Serial1.print(buffer);
		return 0;
	}
	
	mode = i2c_eeprom_read_byte(I2C_EEPROM_ADDRESS, EEPROM_INPUT_MODE_OFFSET + (i-1));
	
	switch (mode) {
		case MODE_MOMENTARY:
			Serial1.println("MODE_MOMENTARY");
			break;
		case MODE_TOGGLE:
			Serial1.println("MODE_TOGGLE");
			break;
		default:
			Serial1.println("Unknown mode");
			break;
	}
}


numvar bl_anyOutputOn (void) {
	uint8_t i;
	
	for (i=0; i<getarg(0);i++) {
		if (getarg(i+1) < 1 || getarg(i+1) > NUM_INPUTS) {
			// Output out of range error message
			strcpy_P(buffer, (PGM_P) pgm_read_word(&(messages[2])));
			Serial1.print(buffer);
			return 0;
		}
	}

	for (i=0; i<getarg(0);i++) {
		if (getOutputState(getarg(i+1)) == 1) {
			return true;
		}
	}
	
	return false;
}

numvar bl_listOutputs (void) {
	uint8_t i,j;
	
	for (i=1;i<NUM_OUTPUTS+1;i++) {
		Serial1.print("#");
		Serial1.print(i);
		Serial1.print(": ");
		if (getOutputState(i) == 1) {
			Serial1.print("ON ");
		} else {
			Serial1.print("OFF");
		}
		
		for (j=0;j<MAX_LABEL_LENGTH;j++) {
			buffer[j] = i2c_eeprom_read_byte(I2C_EEPROM_ADDRESS, EEPROM_OUTPUT_NAME_OFFSET + ((i-1)*MAX_LABEL_LENGTH)+j);
		}
                buffer[j+1] = '\0';
                
		Serial1.print("  ");
		Serial1.print(buffer);
		
		if (i2c_eeprom_read_byte(I2C_EEPROM_ADDRESS, EEPROM_OUTPUT_PRIVATE_FLAG_OFFSET + (i-1))) {
			Serial1.print("  PRIVATE");
		}
		
		Serial1.println();
	}
}

numvar bl_listInputs (void) {
	uint8_t i,j,mode;
	
	for (i=1;i<NUM_INPUTS+1;i++) {
		Serial1.print("#");
		Serial1.print(i);
		Serial1.print(": ");
		mode = i2c_eeprom_read_byte(I2C_EEPROM_ADDRESS, EEPROM_INPUT_MODE_OFFSET + (i-1));
			
		switch (mode) {
			case MODE_MOMENTARY:
				Serial1.print("MODE_MOMENTARY");
				break;
			case MODE_TOGGLE:
				Serial1.print("MODE_TOGGLE");
				break;
			default:
				Serial1.print("Unknown mode");
				break;
		}
		
		for (j=0;j<MAX_LABEL_LENGTH;j++) {
			buffer[j] = i2c_eeprom_read_byte(I2C_EEPROM_ADDRESS, EEPROM_INPUT_NAME_OFFSET + ((i-1)*MAX_LABEL_LENGTH)+j);
		}

                buffer[j+1] = '\0';
                
		Serial1.print("  ");
		Serial1.println(buffer);
	}
}

numvar bl_backupArduinoEEPROM (void) {
    uint16_t i;
    byte value;
    
    Serial1.print("Creating backup: ");
    for (i=0;i<ARDUINO_EEPROM_SIZE;i++) {
        value = EEPROM.read(i);
        if (value != i2c_eeprom_read_byte(I2C_EEPROM_ADDRESS, I2C_EEPROM_BACKUP_ADDRESS + i)) {
            i2c_eeprom_write_byte(I2C_EEPROM_ADDRESS, I2C_EEPROM_BACKUP_ADDRESS + i, value);
            delay(10);
            Serial1.print("+");
        } else {
            Serial1.print("=");
        }
    }
    
    Serial1.print("done. ");

}

numvar bl_peep (void) {
	long i=0;
	byte j;
	long start=0;
	byte b;
	byte buf[8];

	if (getarg(0) != 1) {
		strcpy_P(buffer, (PGM_P) pgm_read_word(&(usage[11])));
		Serial1.println((char *) buffer);
		return 0;
	}

	start = getarg(1);

	for (i=start;i<start+4096;i+=16) {
		i2c_eeprom_read_buffer(I2C_EEPROM_ADDRESS, i, buf, 16);

		speol(); printIntegerInBase(i, 16, 6, '0'); Serial1.print(": ");

		for (j=0;j<16;j++) {
			printIntegerInBase(buf[j], 16, 2, '0');

			Serial1.print(" ");
		}

		for (j=0;j<16;j++) {
			if (isprint(buf[j])) {
				Serial1.write(buf[j]);
			} else {
				Serial1.write(".");
			}
		}
	}

	speol();
}
