raumzeitlabor/lichtsteuerung/(commit log)

2013-02-11 Alles, was ich von Felicitus bekommen habe
    [CONVERS.brd, Lichtsteuerung-Hutschine.brd, Lichtsteuerung-Hutschine.sch, Lichtsteuerung.brd, Lichtsteuerung.sch]
2013-04-01 Konvertierung zu Eagle6, 2 Common Mode Chokes für DMX-IO Filterung hinzugefügt
    [Lichtsteuerung.sch]
2013-04-25 Platine geroutet.
    [Lichtsteuerung.brd, Lichtsteuerung.sch]
2013-04-29 Added BOM, updated parts
    [Lichtsteuerung BOM.csv, Lichtsteuerung.brd, Lichtsteuerung.sch]
2013-04-29 Added pin descriptions to board, easter egg.
    [Lichtsteuerung.brd, Lichtsteuerung.sch]
2013-04-30 RZL-Logo muss sein.
    [Lichtsteuerung.brd]
2013-05-03 Removed old board/schematic
    [CONVERS.brd, Lichtsteuerung-Hutschine.brd, Lichtsteuerung-Hutschine.sch, Lichtsteuerung.brd, Lichtsteuerung.sch]
2013-05-11 Added polyfuses for the 24V rails
    [Lichtsteuerung.brd, Lichtsteuerung.sch]
2013-05-14 Fixed wrong battery holder
    [Lichtsteuerung.brd, Lichtsteuerung.sch]
2013-05-14 Added missing bypass cap for the second avr
    [Lichtsteuerung.brd, Lichtsteuerung.sch]
2013-05-14 Fixed serial eeprom footprint
    [Lichtsteuerung.brd, Lichtsteuerung.sch]
2013-05-15 Fixed typo
    [Lichtsteuerung.sch]
2013-05-15 Added another aux connector to supply SDA, SCL, +5V and GND
    [Lichtsteuerung.brd, Lichtsteuerung.sch]
2013-05-20 - Added GND for I²C connector - Added LEDs for power indication - Added output enable for shift registers - Moved pin headers to make room for cable - Added pullup/pulldown resistors and SMD jumpers 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
    [Lichtsteuerung.brd, Lichtsteuerung.sch]
2013-05-20 Swapped RXD and TXD, because this is a DCE, not a DTE. In plain words: You can simply connect any USB-RS232 connector to the port now, instead of using a null modem cable with crossed RXD/TXD pairs.
    [Lichtsteuerung.brd, Lichtsteuerung.sch]
2013-05-24 Changed CR2032 battery holder with a vertical one to allow easier replacements
    [Lichtsteuerung.brd, Lichtsteuerung.sch]
2013-06-04 Added missing pulldowns for the optocoupler inputs
    [Lichtsteuerung.brd, Lichtsteuerung.sch]
2013-07-12 Added new high-speed optocouplers
    [Lichtsteuerung.brd, Lichtsteuerung.sch]
2013-08-12 Re-added smd jumpers, fixed silkscreens and added a few test points
    [Lichtsteuerung.brd, Lichtsteuerung.sch]
2013-08-12 Added reichelt ordercodes
    [Lichtsteuerung.brd, Lichtsteuerung.sch]
2013-08-12 Fake commit to test the board gen hook
    [Lichtsteuerung.brd, Lichtsteuerung.sch]
2013-08-12 Another hook test
    [Lichtsteuerung.brd, Lichtsteuerung.sch]
2013-08-12 Final hook test, seems to work
    [Lichtsteuerung.brd, Lichtsteuerung.sch]
2013-08-20 Fixed ACPL-M50L footprint size
    [Lichtsteuerung.brd, Lichtsteuerung.sch]
2013-10-02 Added initial arduino firmware.
2013-10-06 Changed pulldown resistors from 10k to 47k for the input optocouplers
    [Lichtsteuerung.brd, Lichtsteuerung.sch]
2013-10-09 Replaced atmega8 with atmega168 in order to use the DMXSerial library
    [Lichtsteuerung.brd, Lichtsteuerung.sch]
2013-10-09 Added experimental external power input, needs review from DaFo
    [Lichtsteuerung.brd, Lichtsteuerung.sch]
2013-12-05 Fixed doc for setOutputState
    [bitlashfunctions.ino]
2013-12-14 Initial revision F
    Changes:
    * Removed Atmega8 + second RS485 interface, because we're using an RS485 hub and RDM instead
    * Added more (software controlled) status LEDs
    * Added optional external VCC for the relais drivers
    * Replaced SMD solder jumpers with real jumpers for DMX Term / Pull Up / Pull Down
    * All components placed now on the first layer, in order to allow reflowing of the components
    [Lichtsteuerung.brd, Lichtsteuerung.sch]
2013-12-14 Finalized Revision F
    [Lichtsteuerung.brd, Lichtsteuerung.sch]
2013-12-14 Moved stuff from tValues to tNames layer
    [Lichtsteuerung.brd]
2013-12-14 Added missing designator for C4
    [Lichtsteuerung.brd]
2013-12-14 Additions: - Added POWER OK LEDs for the inputs/outputs with constant current source (in case we need to connect other voltages and a fixed resistors won't help) - Added test points for all major sig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
    [Lichtsteuerung.brd, Lichtsteuerung.sch]
2013-12-14 - Moved POWEROK to the tNames layer and adjusted their size
    [Lichtsteuerung.brd]
2013-12-14 Implemented getDMXStartAddress, getRDMUID, setOutputName, getOutputName, setOutputState, getOutputState, toggleOutputState, setInputName and getInputName.
    getInputName, setInputName, getOutputName and setOutputName are not functional yet, because I can't test if the I²C EEPROM is working due to a wiring error.
    [Lichtsteuerung.ino, bitlashfunctions.ino, functions.ino]
2014-01-13 - Added some more missing functions (anyoutputon, listoutputs, setinputmode, getinputmode) - Added responder for message E120_DEFAULT_SLOT_VALUE - Block DMX input if DMX input differs from internal s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
    [Lichtsteuerung.ino, bitlashfunctions.ino, functions.ino, i2c_eeprom.ino]
2014-02-10 Fixed overlap
    [Lichtsteuerung.brd]
2014-02-12 Return the slot name via RDM using slot_description
2014-02-21 Updated part ordering numbers, added connector plugs and case to the BOM
    [Lichtsteuerung.brd, Lichtsteuerung.sch]
2014-08-16 Added instructions for installing arduino 1.5 on wheezy/jessie
2015-09-19 Fixed length for ON/OFF strings
    [bitlashfunctions.ino]
2015-09-19 Fixed LM317 to use constant current mode
    [Lichtsteuerung.brd, Lichtsteuerung.sch]
2016-08-28 Added TVS Diode and 100n capacitor for the reset line
    [Lichtsteuerung.brd, Lichtsteuerung.sch]
